JohnKuruvila/charger-stand/concept/tex/dial.png

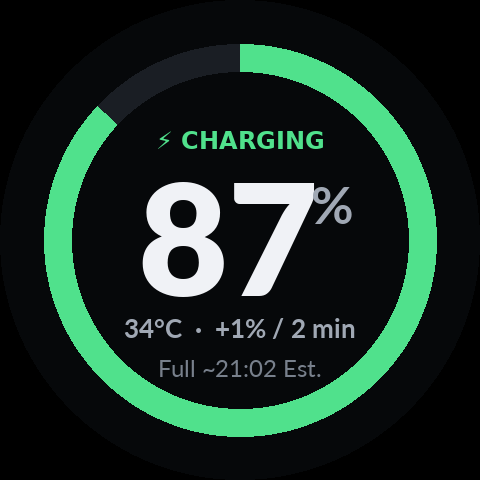
concept/tex/dial.png
