JohnKuruvila/charger-stand/concept/tex/lock_portrait.png

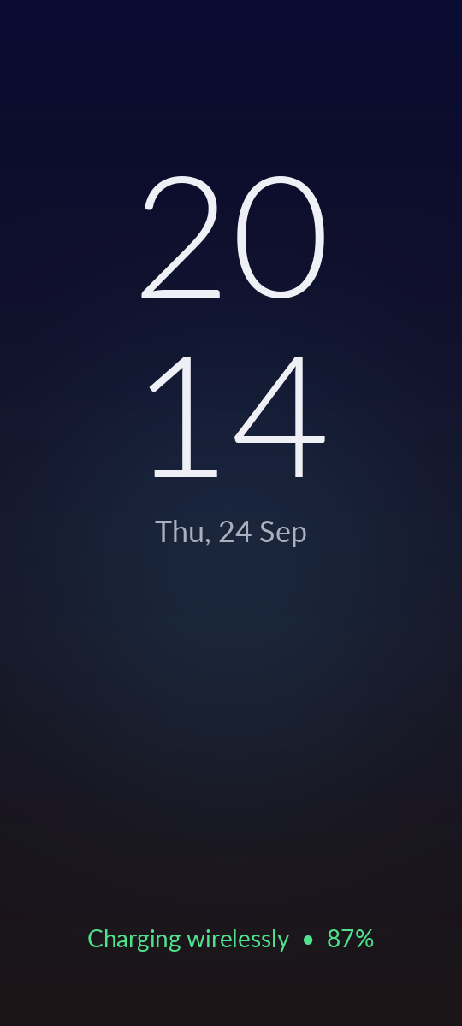
concept/tex/lock_portrait.png
