JohnKuruvila/charger-stand/cad/out/w6_assembly.step

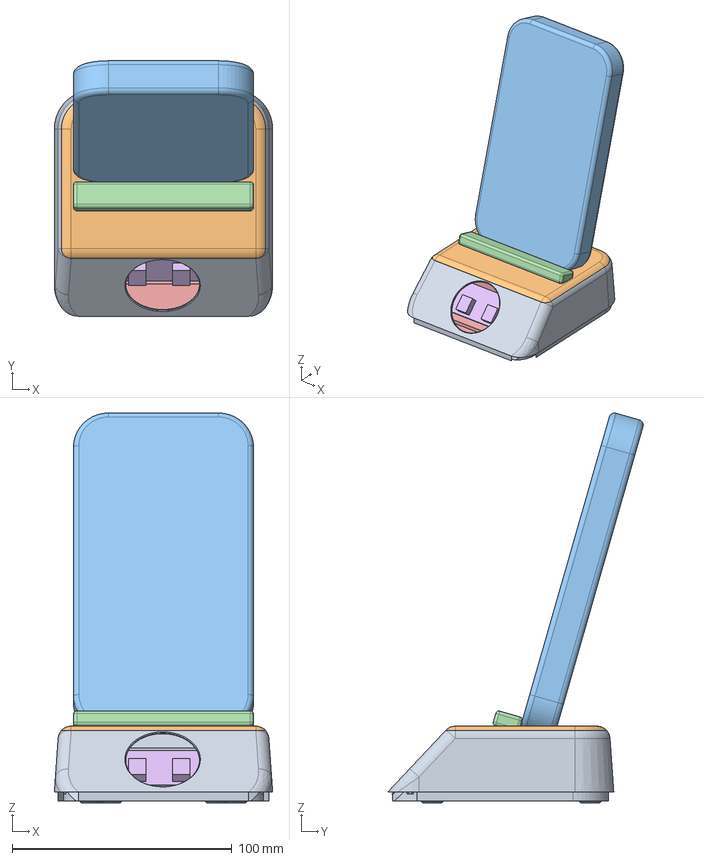
[picture p5: CAD file, 2026-10-12]
cad/out/w6_assembly.step
99.4 x 116.4 x 177.6 mm
