JohnKuruvila/charger-stand/cad/out/coupons/coupon_display_face.3mf

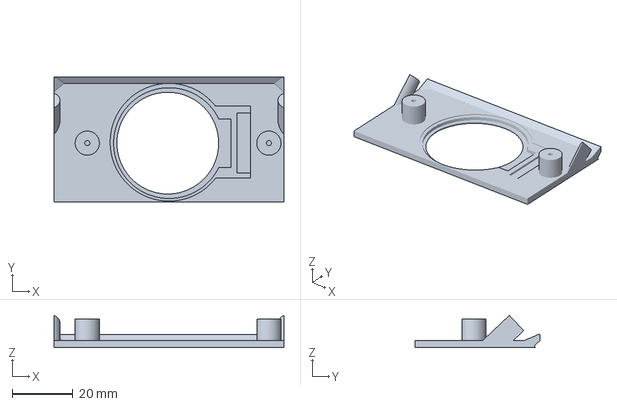
[picture p6: CAD file, 2026-10-12]
cad/out/coupons/coupon_display_face.3mf
76.0 x 41.4 x 10.7 mm
