JohnKuruvila/charger-stand/cad/out/plates/brown_parts.3mf

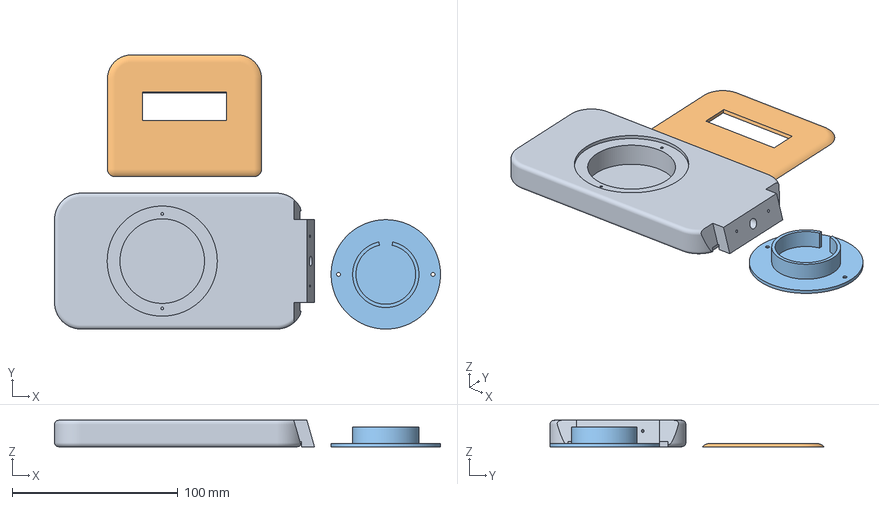
[picture p7: CAD file, 2026-10-12]
cad/out/plates/brown_parts.3mf
232.9 x 165.4 x 16.0 mm
backrest
cap
coil_cover
