JohnKuruvila/charger-stand/cad/out/print/plate.3mf

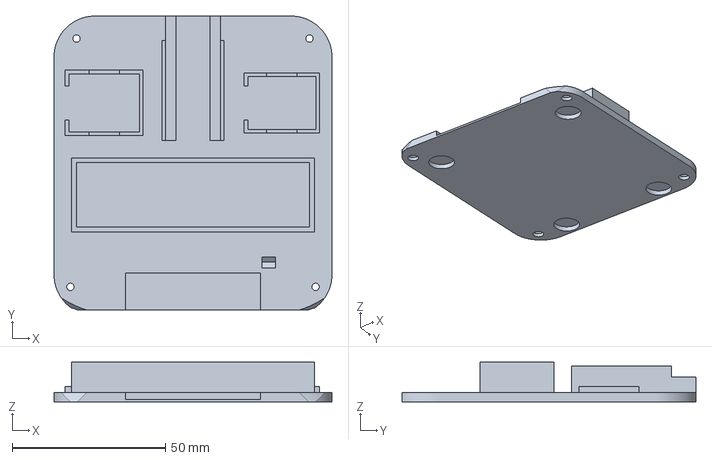
[picture p8: CAD file, 2026-10-12]
cad/out/print/plate.3mf
90.7 x 95.9 x 13.0 mm
