JohnKuruvila/charger-stand/cad/out/coupons/coupon_coil_pocket.3mf

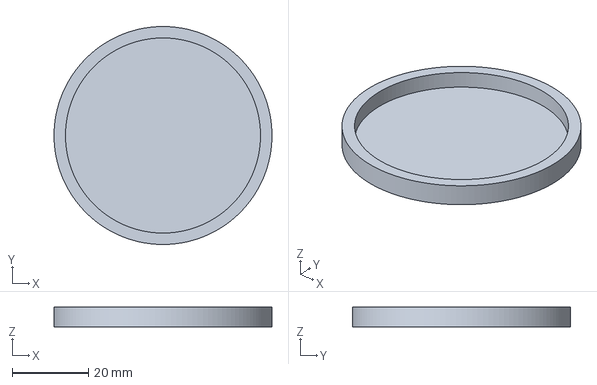
[picture p9: CAD file, 2026-10-12]
cad/out/coupons/coupon_coil_pocket.3mf
57.0 x 57.0 x 5.20 mm
