JohnKuruvila/charger-stand/cad/out/plates/bottom_parts.3mf

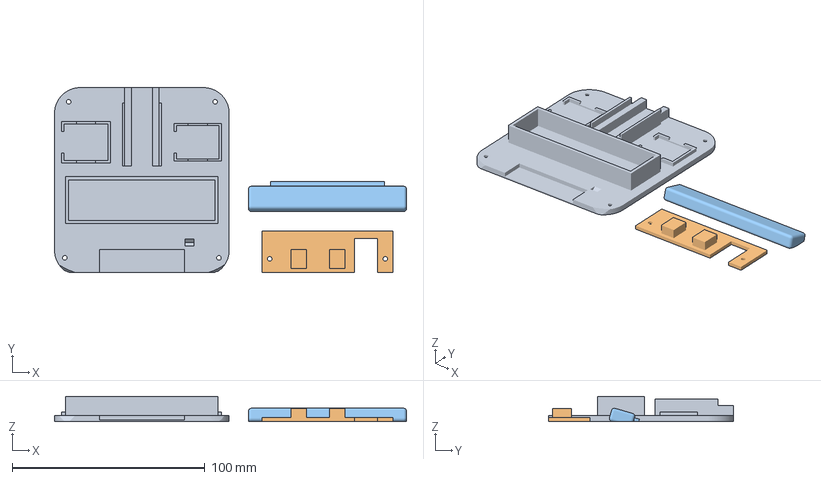
[picture p10: CAD file, 2026-10-12]
cad/out/plates/bottom_parts.3mf
182.7 x 95.9 x 13.0 mm
plate
retainer
lip
