JohnKuruvila/charger-stand/cad/out/print/lip.3mf

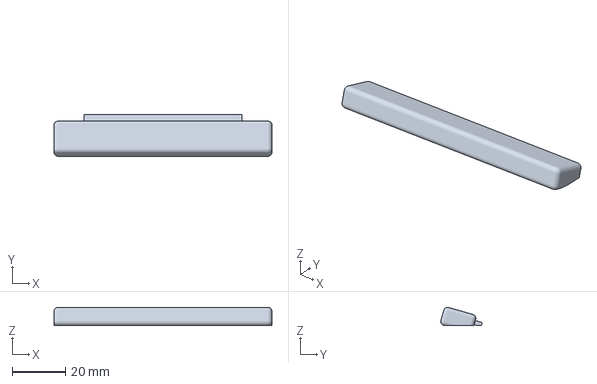
[picture p11: CAD file, 2026-10-12]
cad/out/print/lip.3mf
82.0 x 15.6 x 6.90 mm
