JohnKuruvila/charger-stand/cad/out/coupons/coupon_tenon.3mf

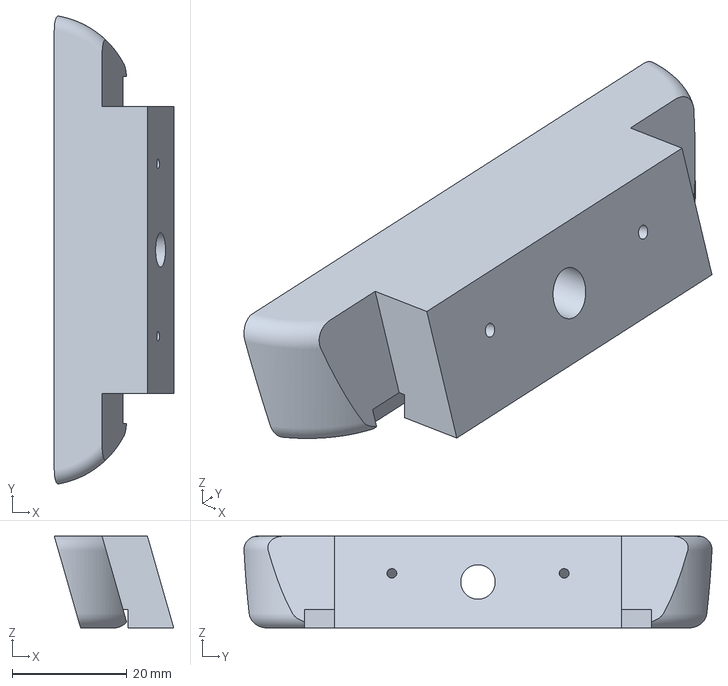
[picture p12: CAD file, 2026-10-12]
cad/out/coupons/coupon_tenon.3mf
20.8 x 81.5 x 16.0 mm
