JohnKuruvila/charger-stand/cad/out/plates/pla_coupons.3mf

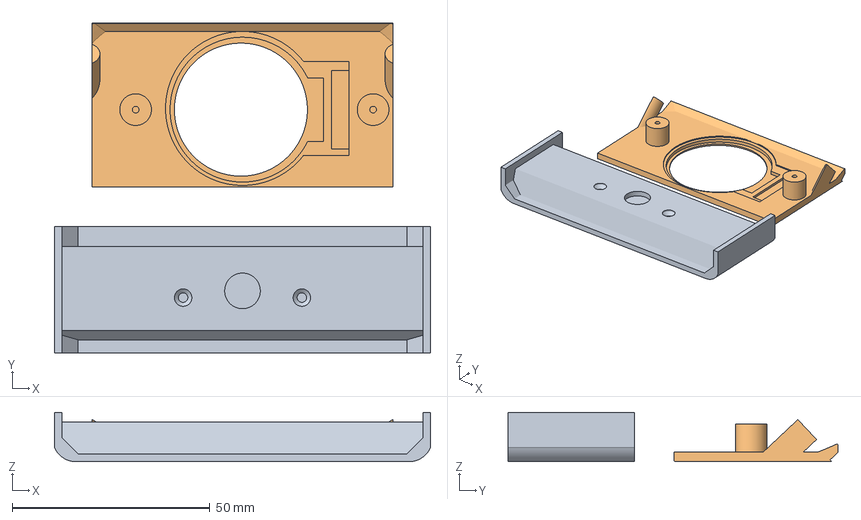
[picture p13: CAD file, 2026-10-12]
cad/out/plates/pla_coupons.3mf
95.0 x 83.4 x 12.5 mm
coupon_socket
coupon_display_face
