JohnKuruvila/charger-stand/cad/out/print/base.3mf

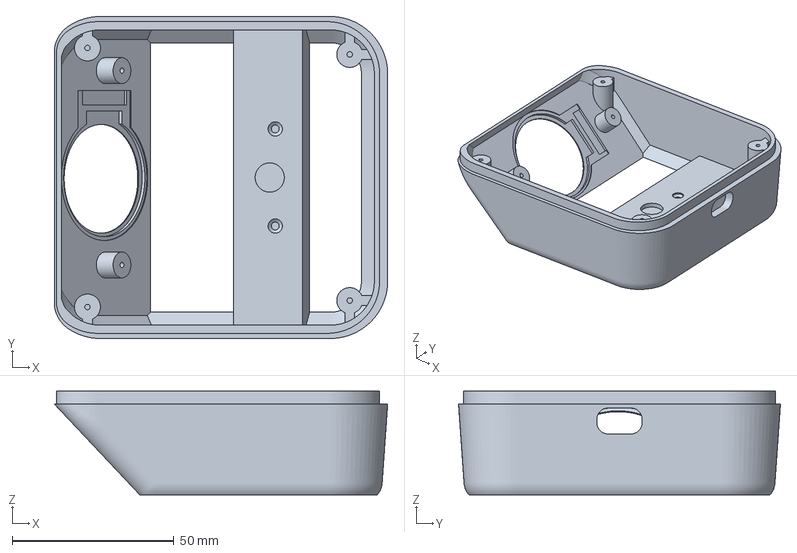
[picture p14: CAD file, 2026-10-12]
cad/out/print/base.3mf
103.0 x 99.4 x 32.0 mm
