JohnKuruvila/charger-stand/cad/out/coupons/coupon_glass.3mf

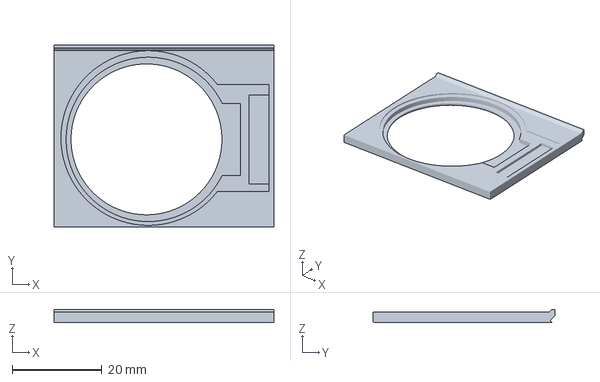
[picture p15: CAD file, 2026-10-12]
cad/out/coupons/coupon_glass.3mf
49.0 x 40.5 x 3.00 mm
