JohnKuruvila/charger-stand/cad/out/plates/joint_coupons.3mf

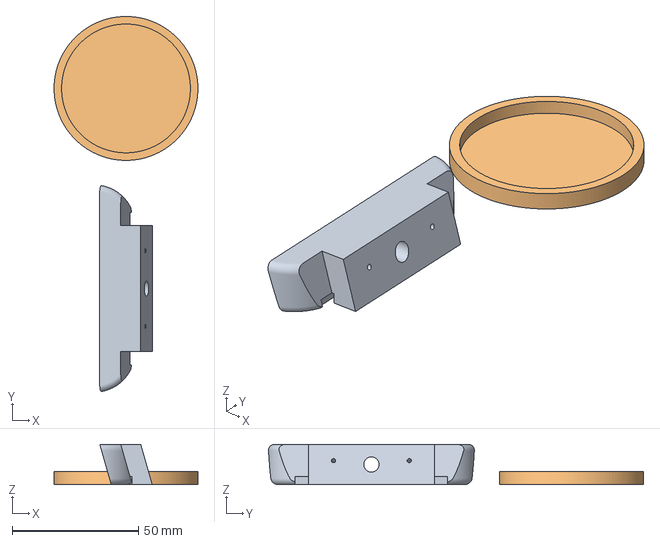
[picture p16: CAD file, 2026-10-12]
cad/out/plates/joint_coupons.3mf
57.0 x 148.5 x 16.0 mm
coupon_tenon
coupon_coil_pocket
