JohnKuruvila/charger-stand/cad/out/print/backrest.3mf

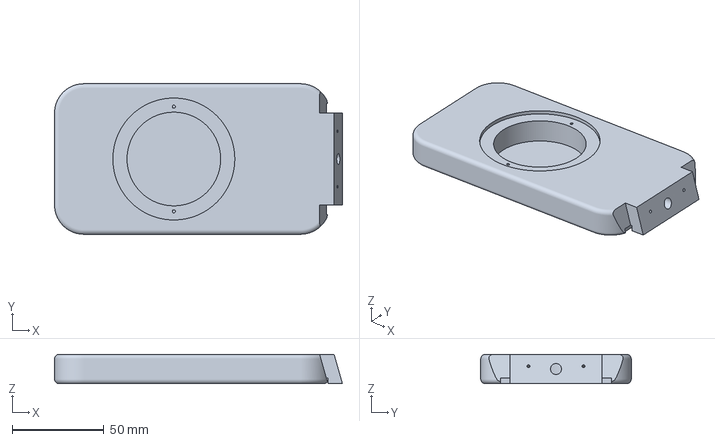
[picture p17: CAD file, 2026-10-12]
cad/out/print/backrest.3mf
156.9 x 82.0 x 16.0 mm
