JohnKuruvila/charger-stand/cad/out/print/feet.3mf

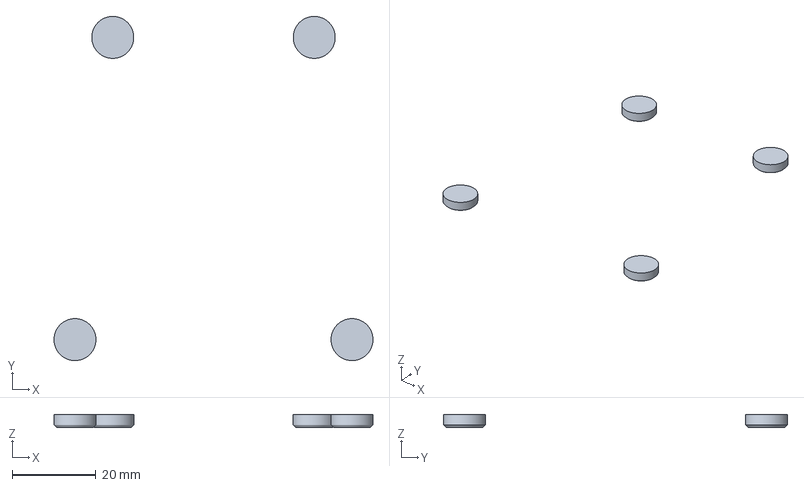
[picture p18: CAD file, 2026-10-12]
cad/out/print/feet.3mf
76.0 x 82.0 x 3.00 mm
