JohnKuruvila/charger-stand/cad/out/coupons/coupon_socket.3mf

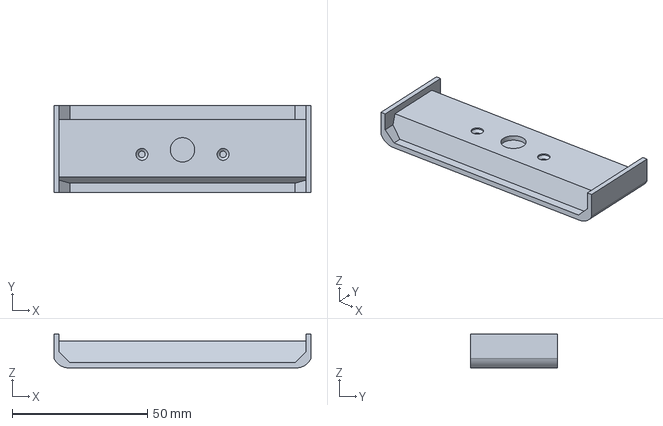
[picture p19: CAD file, 2026-10-12]
cad/out/coupons/coupon_socket.3mf
95.0 x 32.0 x 12.5 mm
