JohnKuruvila/charger-stand/cad/out/print/retainer.3mf

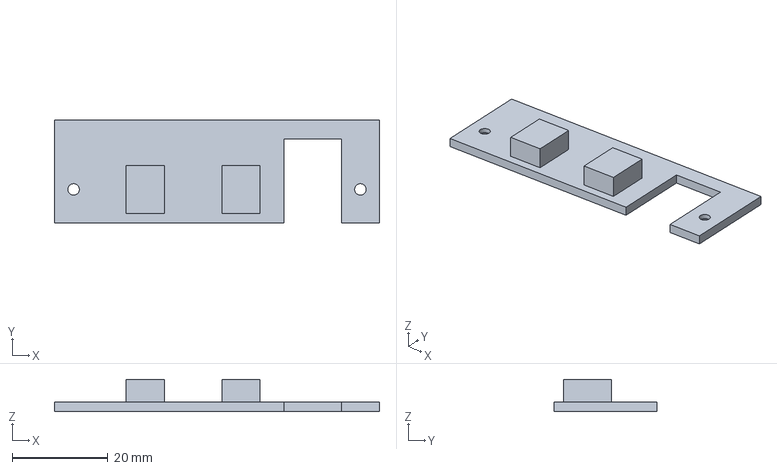
[picture p20: CAD file, 2026-10-12]
cad/out/print/retainer.3mf
68.0 x 21.5 x 6.70 mm
