JohnKuruvila/charger-stand/cad/out/print/cap.3mf

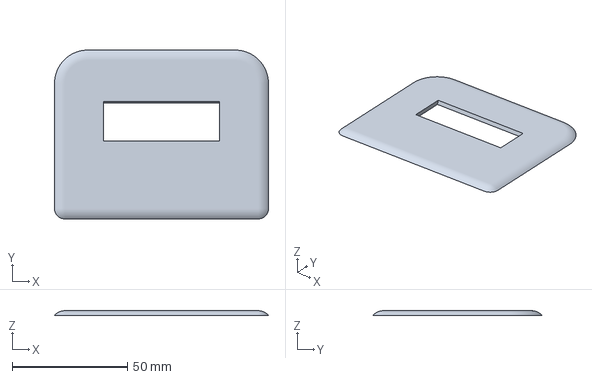
[picture p21: CAD file, 2026-10-12]
cad/out/print/cap.3mf
93.0 x 73.4 x 2.00 mm
