JohnKuruvila/charger-stand/cad/out/print/coil_cover.3mf

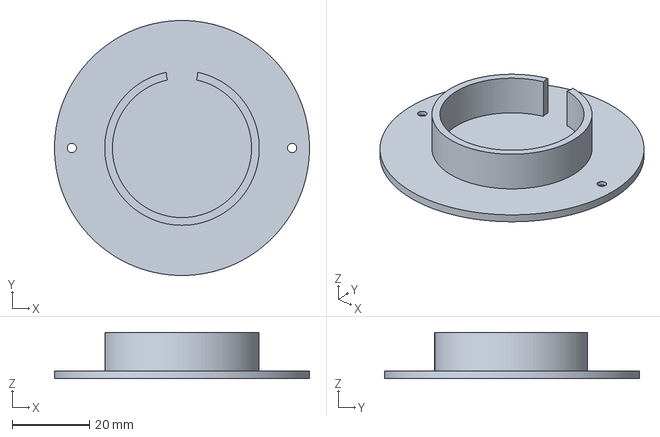
[picture p22: CAD file, 2026-10-12]
cad/out/print/coil_cover.3mf
66.0 x 66.0 x 12.0 mm
