JohnKuruvila/charger-stand/(list of files, cad)

Other CAD files:
cad/out/coupons/coupon_coil_pocket.stl
cad/out/coupons/coupon_display_face.stl
cad/out/coupons/coupon_glass.stl
cad/out/coupons/coupon_screws.3mf
cad/out/coupons/coupon_screws.stl
cad/out/coupons/coupon_socket.stl
cad/out/coupons/coupon_tenon.stl
cad/out/print/backrest.stl
cad/out/print/base.stl
cad/out/print/cap.stl
cad/out/print/coil_cover.stl
cad/out/print/feet.stl
cad/out/print/lip.stl
cad/out/print/plate.stl
cad/out/print/retainer.stl
