JohnKuruvila/charger-stand/firmware/w6/src/wood.cpp

// Walnut grain's wood, made by tools/make_wood.sh from tools/wood.cpp. Don't edit: change wood.cpp and run it.
#include <stdint.h>

// Each row's half-width: row y holds pixels 120 - w to 119 + w
extern const uint8_t WOOD_HALF_W[240] = {
    11, 19, 25, 29, 33, 36, 39, 42, 45, 47, 50, 52, 54, 56, 58, 59, 61, 63, 65, 66, 68, 69, 70, 72,
    73, 74, 76, 77, 78, 79, 80, 82, 83, 84, 85, 86, 87, 88, 89, 89, 90, 91, 92, 93, 94, 95, 95, 96,
    97, 98, 98, 99, 100, 100, 101, 102, 102, 103, 104, 104, 105, 105, 106, 106, 107, 107, 108, 108, 109, 109, 110, 110,
    111, 111, 112, 112, 112, 113, 113, 113, 114, 114, 114, 115, 115, 115, 116, 116, 116, 117, 117, 117, 117, 118, 118, 118,
    118, 118, 119, 119, 119, 119, 119, 119, 119, 120, 120, 120, 120, 120, 120, 120, 120, 120, 120, 120, 120, 120, 120, 120,
    120, 120, 120, 120, 120, 120, 120, 120, 120, 120, 120, 120, 120, 120, 120, 119, 119, 119, 119, 119, 119, 119, 118, 118,
    118, 118, 118, 117, 117, 117, 117, 116, 116, 116, 115, 115, 115, 114, 114, 114, 113, 113, 113, 112, 112, 112, 111, 111,
    110, 110, 109, 109, 108, 108, 107, 107, 106, 106, 105, 105, 104, 104, 103, 102, 102, 101, 100, 100, 99, 98, 98, 97,
    96, 95, 95, 94, 93, 92, 91, 90, 89, 89, 88, 87, 86, 85, 84, 83, 82, 80, 79, 78, 77, 76, 74, 73,
    72, 70, 69, 68, 66, 65, 63, 61, 59, 58, 56, 54, 52, 50, 47, 45, 42, 39, 36, 33, 29, 25, 19, 11};

extern const uint16_t WOOD_ROW[240] = {
    0, 22, 60, 110, 168, 234, 306, 384, 468, 558, 652, 752, 856, 964, 1076, 1192,
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
    0x28C2, 0x20A2, 0x30E2, 0x30C2, 0x28C2, 0x28C2, 0x28C2, 0x28C2, 0x30E2, 0x28C2, 0x28C2, 0x30E2,
    0x4984, 0x4163, 0x4984, 0x4164, 0x4984, 0x4183, 0x4984, 0x4163, 0x4984, 0x4163, 0x4984, 0x4984,
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
